LucioFex/gavia-hardware/docs/renders/conceptos_agua.jpg

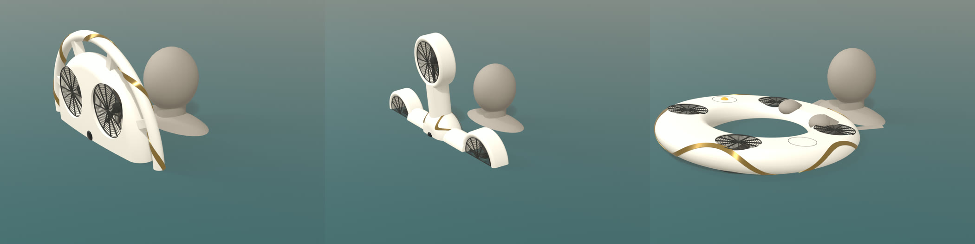
docs/renders/conceptos_agua.jpg
