LucioFex/gavia-hardware/docs/renders/gavia_aro_2_frente.jpg

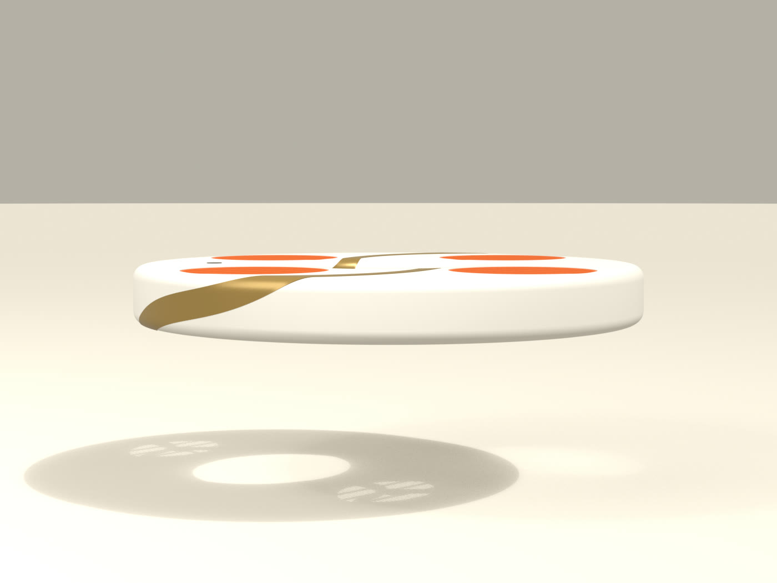
docs/renders/gavia_aro_2_frente.jpg
