LucioFex/gavia-hardware/docs/renders/gavia_aro_3_arriba.jpg

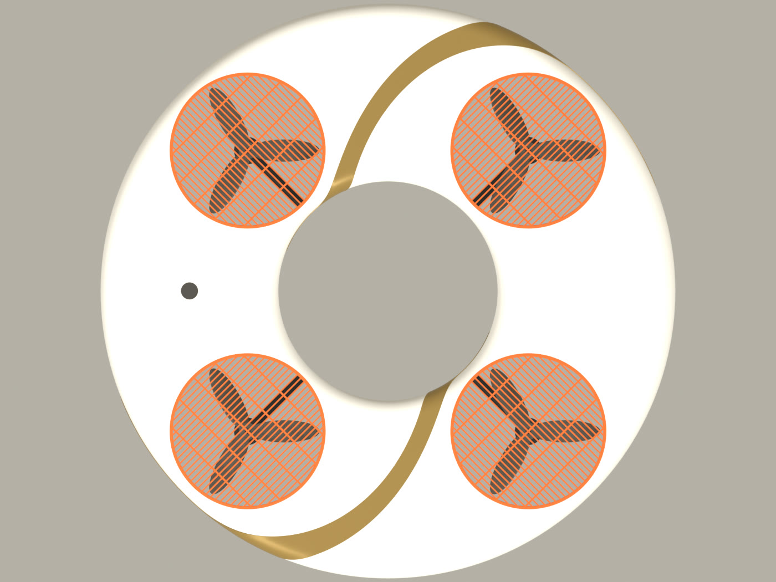
docs/renders/gavia_aro_3_arriba.jpg
