LucioFex/gavia-hardware/docs/renders/gavia_aro_4_detalle.jpg

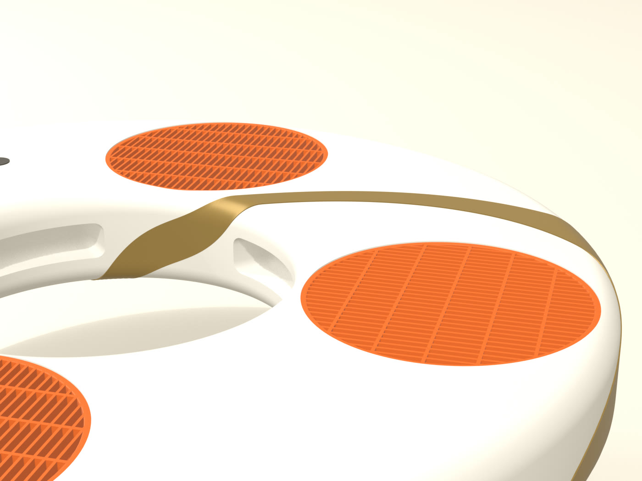
docs/renders/gavia_aro_4_detalle.jpg
