LucioFex/gavia-hardware/docs/renders/gavia_aro_5_agua.jpg

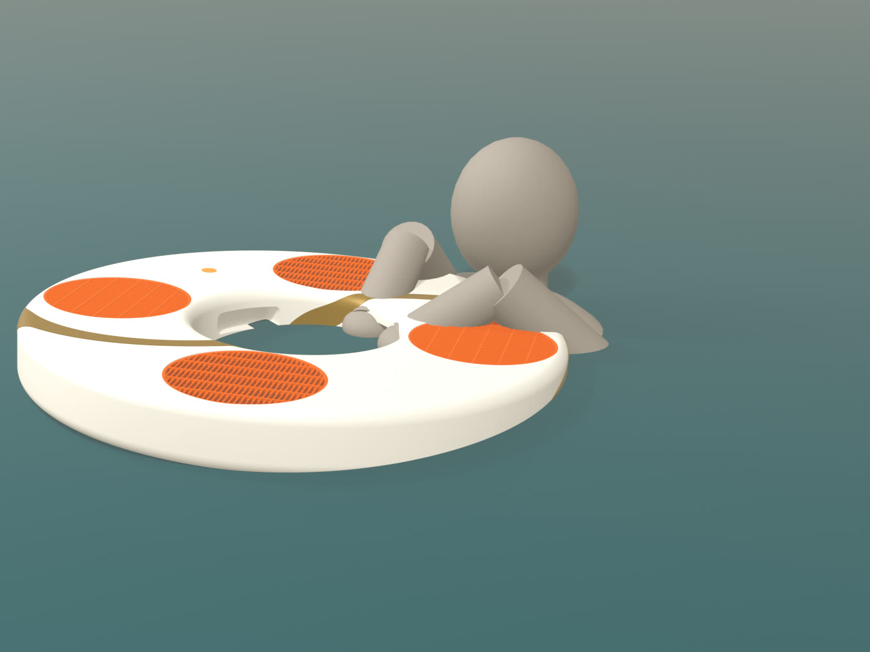
docs/renders/gavia_aro_5_agua.jpg
