LucioFex/gavia-hardware/docs/renders/gavia_aro_6_agua_guardavidas.jpg

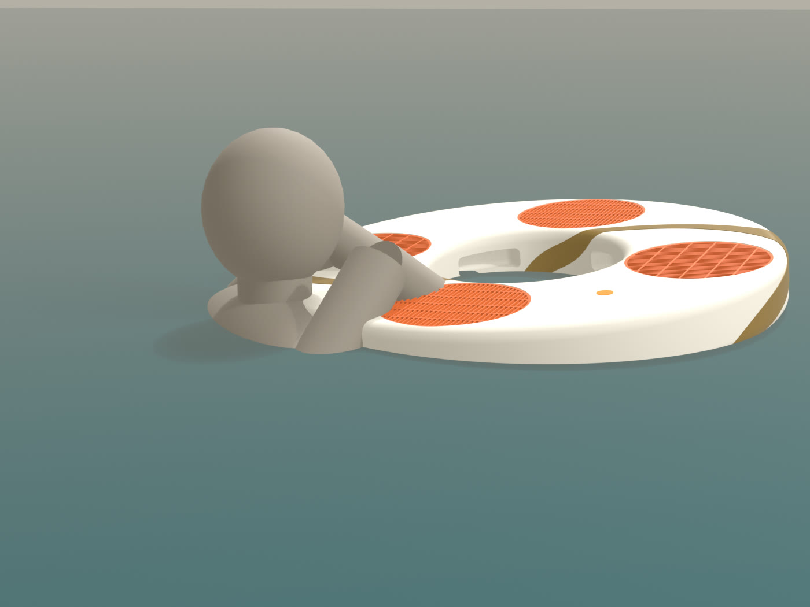
docs/renders/gavia_aro_6_agua_guardavidas.jpg
