LucioFex/gavia-hardware/docs/renders/gavia_aro_7_abajo.jpg

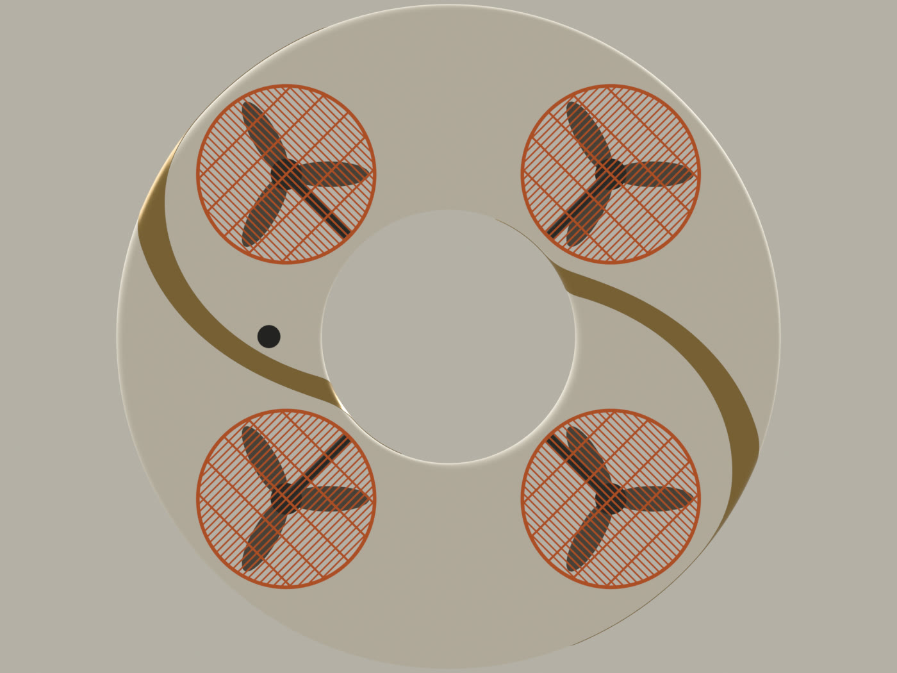
docs/renders/gavia_aro_7_abajo.jpg
