LucioFex/gavia-hardware/docs/renders/gavia_botonera_2_frente.jpg

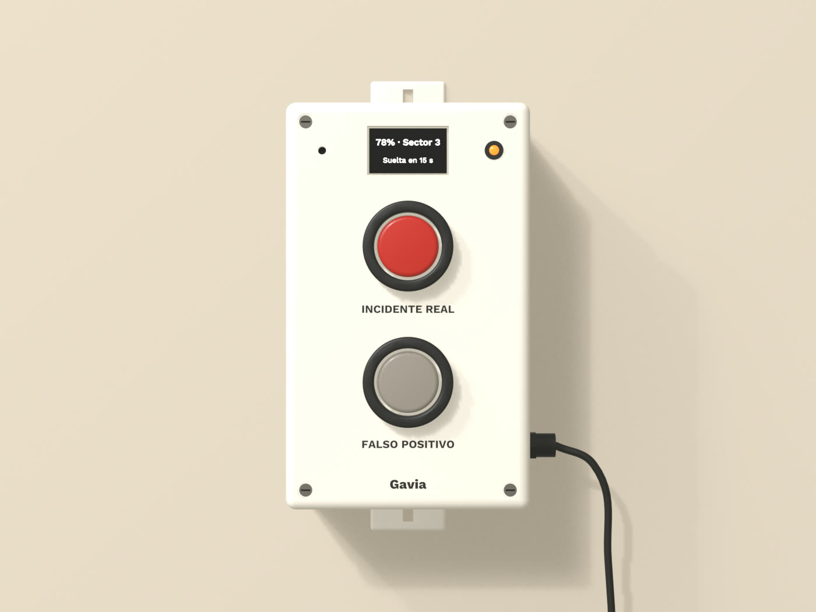
docs/renders/gavia_botonera_2_frente.jpg
