LucioFex/gavia-hardware/docs/renders/gavia_botonera_3_en_la_torre.jpg

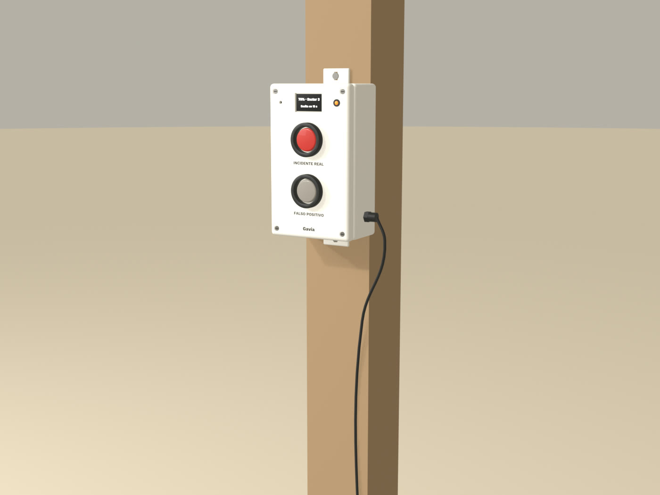
docs/renders/gavia_botonera_3_en_la_torre.jpg
