LucioFex/gavia-hardware/docs/roadmap/img/01-banco.jpg

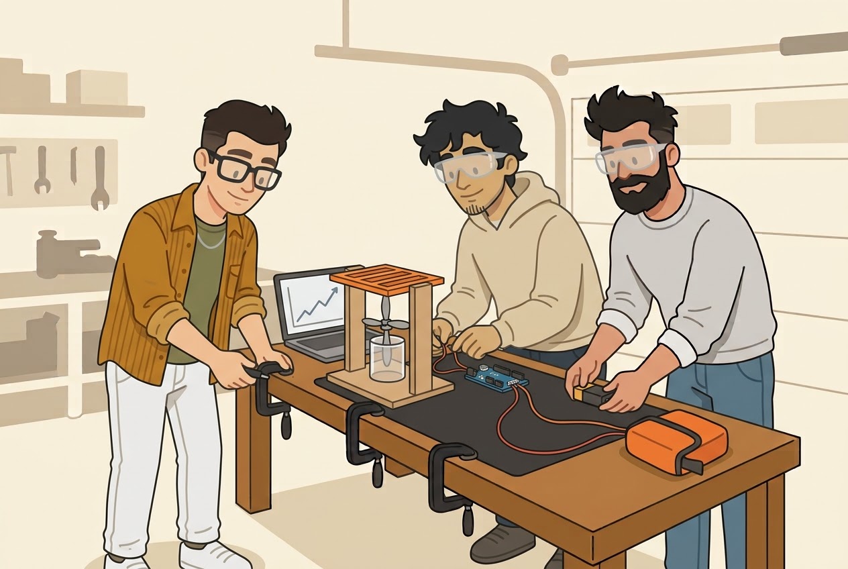
docs/roadmap/img/01-banco.jpg
