LucioFex/gavia-hardware/docs/roadmap/img/02-ducto.jpg

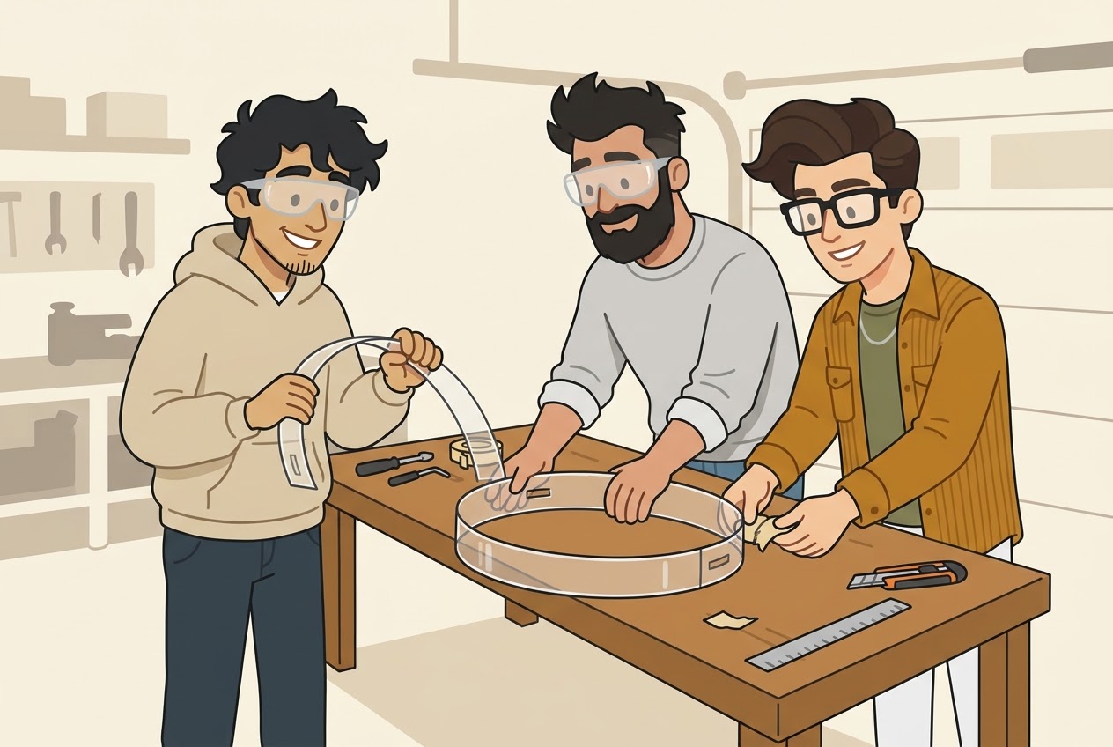
docs/roadmap/img/02-ducto.jpg
