LucioFex/gavia-hardware/docs/roadmap/img/03-soldar.jpg

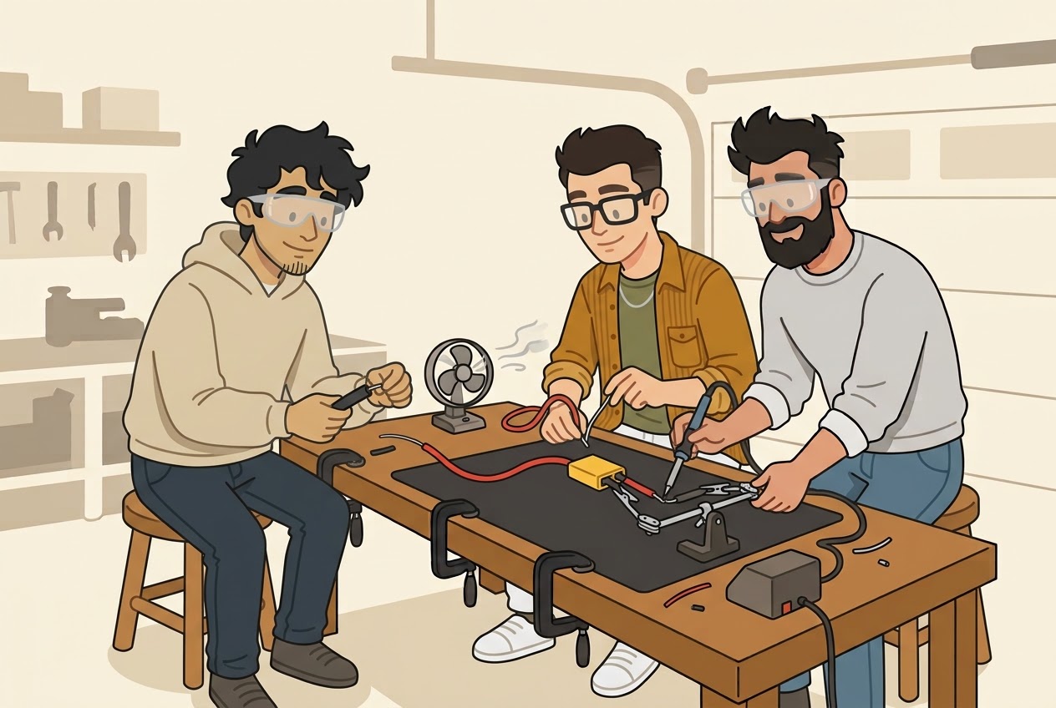
docs/roadmap/img/03-soldar.jpg
