LucioFex/gavia-hardware/docs/roadmap/img/06-taller.jpg

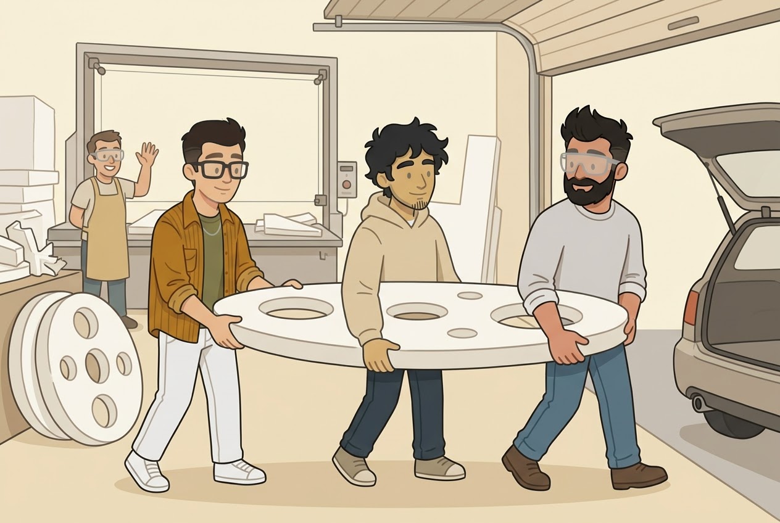
docs/roadmap/img/06-taller.jpg
