LucioFex/gavia-hardware/docs/roadmap/img/07-capas.jpg

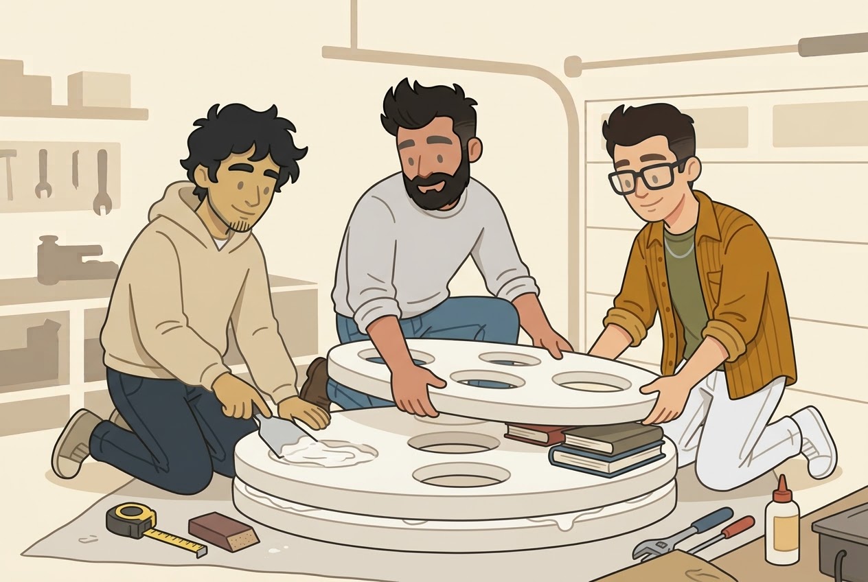
docs/roadmap/img/07-capas.jpg
