LucioFex/gavia-hardware/docs/roadmap/img/09-electronica.jpg

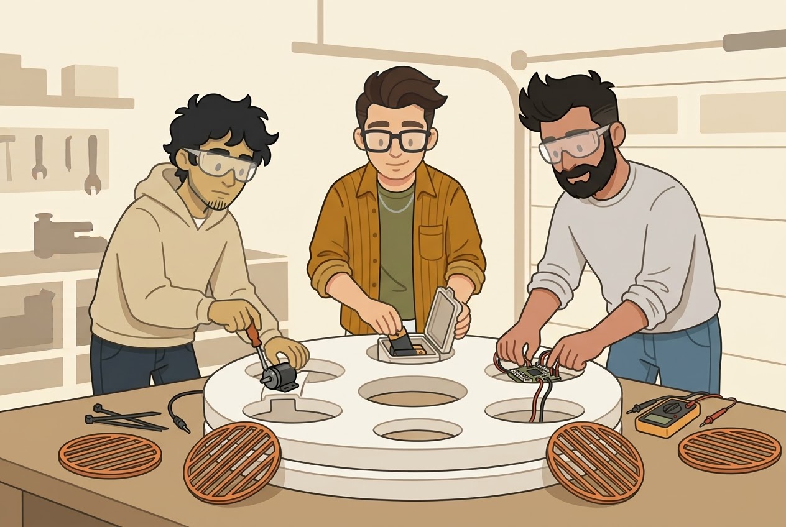
docs/roadmap/img/09-electronica.jpg
