LucioFex/gavia-hardware/docs/roadmap/img/10-vuelo-atado.jpg

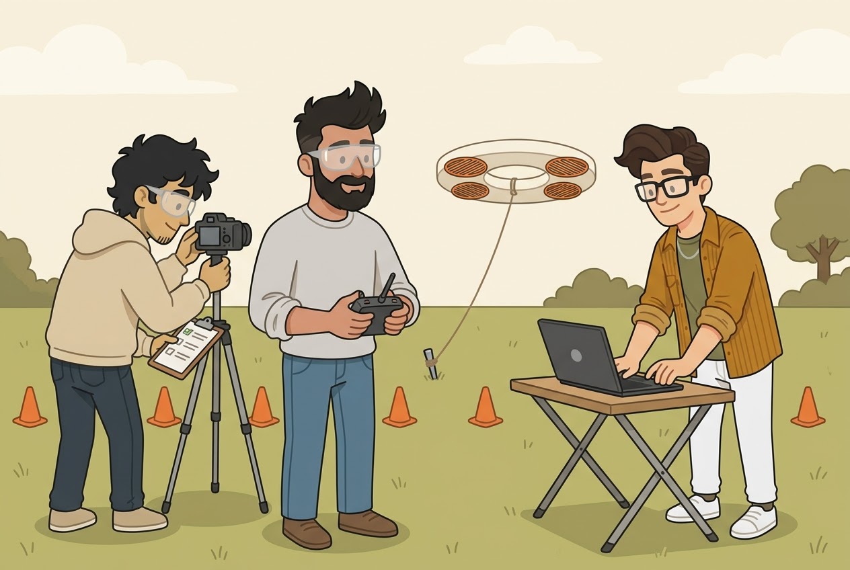
docs/roadmap/img/10-vuelo-atado.jpg
