LucioFex/gavia-hardware/docs/roadmap/img/11-playa.jpg

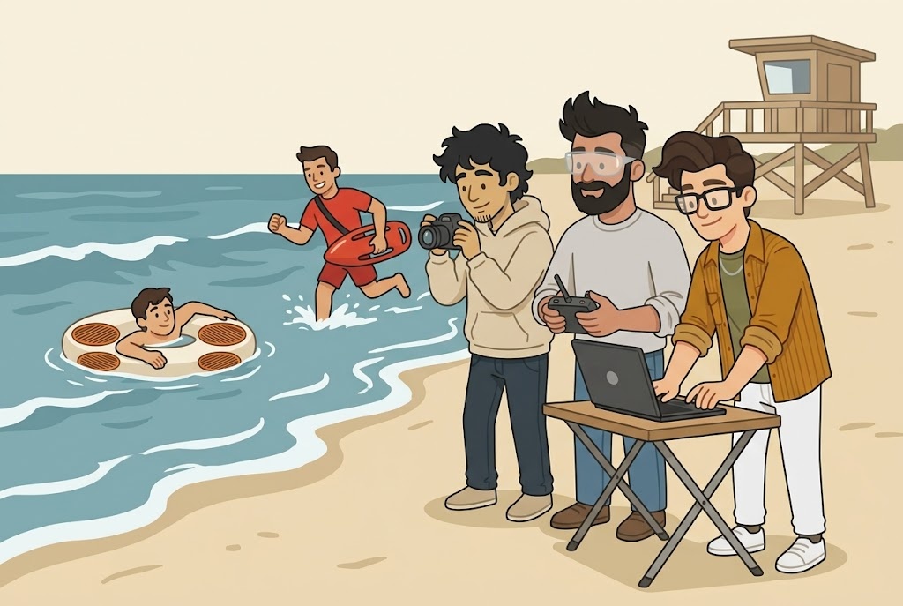
docs/roadmap/img/11-playa.jpg
