LucioFex/gavia-hardware/docs/materiales-y-conceptos/img/rejilla.png

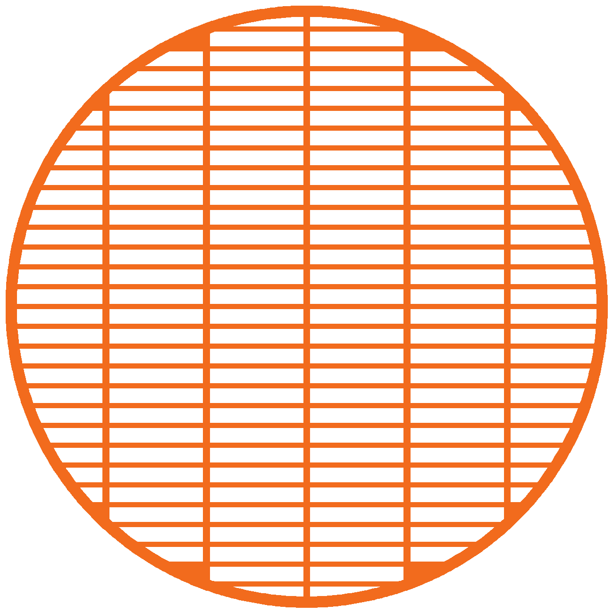
docs/materiales-y-conceptos/img/rejilla.png
