LucioFex/gavia-hardware/cad/banco/banco_mdf_1.dxf

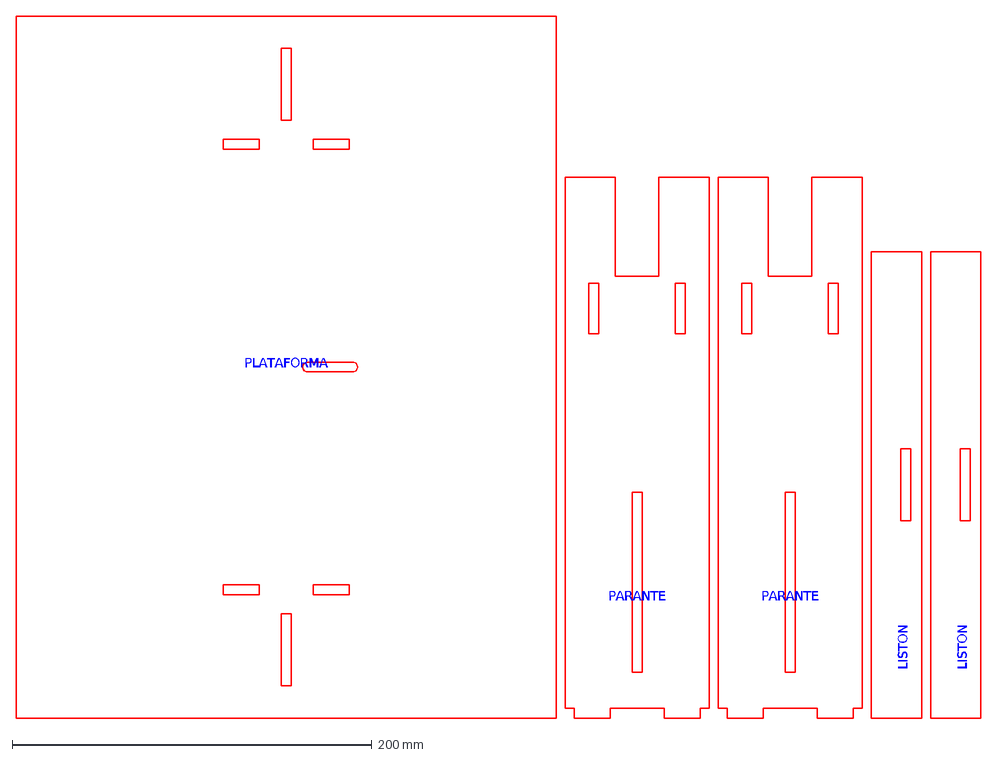
[picture p36: CAD file, 2026-10-30]
cad/banco/banco_mdf_1.dxf
PLATAFORMA
PARANTE
LISTON
