LucioFex/gavia-hardware/cad/cuerpo/capa_media.dxf

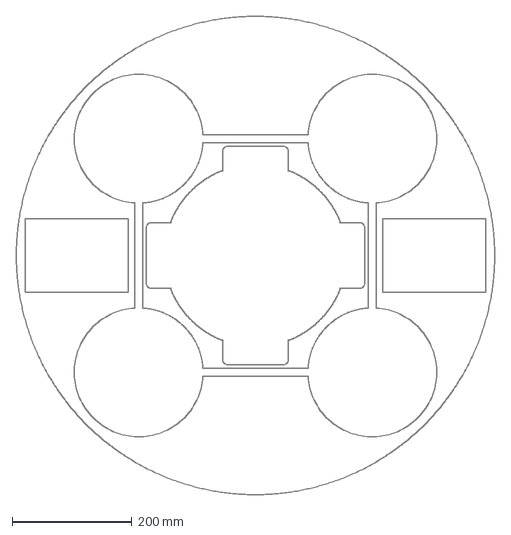
[picture p37: CAD file, 2026-10-30]
cad/cuerpo/capa_media.dxf
799.2 x 799.2 mm
