LucioFex/gavia-hardware/cad/banco/banco_mdf_2.dxf

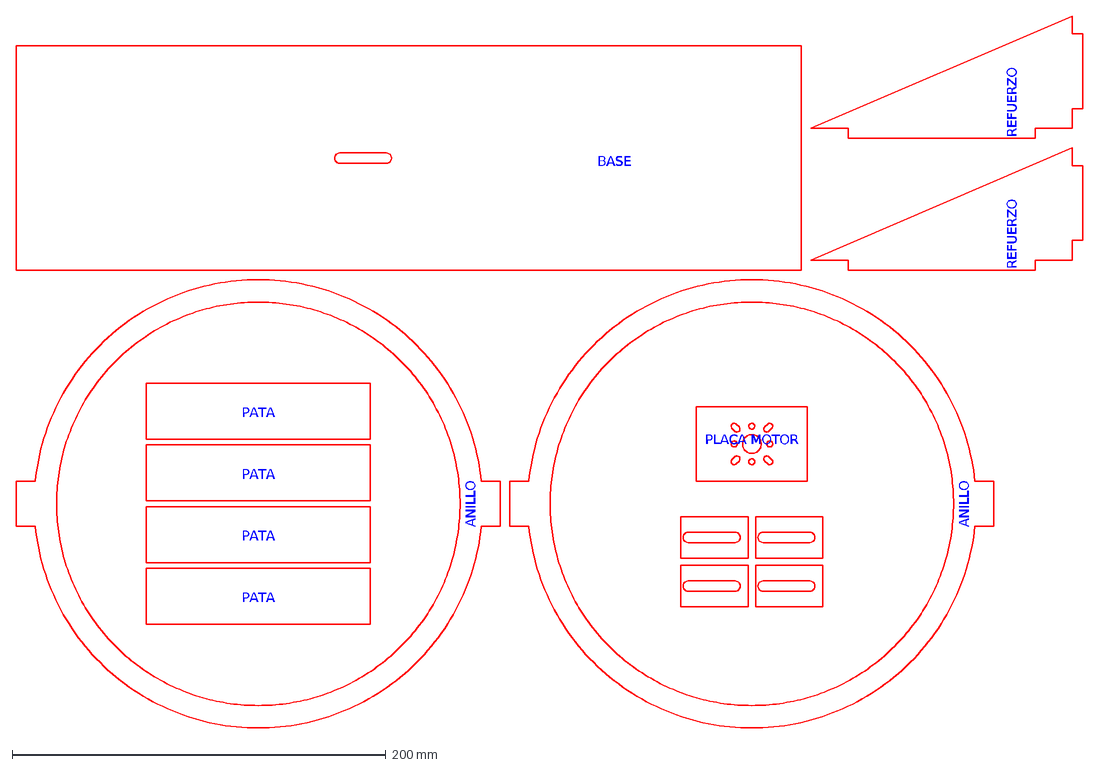
[picture p38: CAD file, 2026-10-30]
cad/banco/banco_mdf_2.dxf
ANILLO
PATA
PLACA MOTOR
BASE
REFUERZO
