LucioFex/gavia-hardware/cad/cuerpo/tapon_caja.dxf

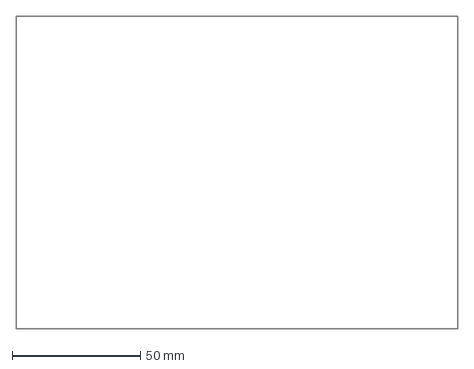
[picture p39: CAD file, 2026-10-30]
cad/cuerpo/tapon_caja.dxf
172.0 x 122.0 mm
