LucioFex/gavia-hardware/cad/banco/rejilla_banco.dxf

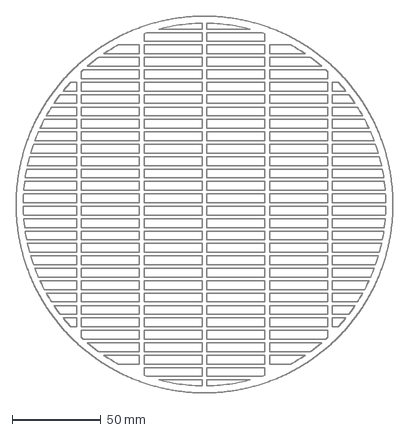
[picture p40: CAD file, 2026-10-30]
cad/banco/rejilla_banco.dxf
212.6 x 212.6 mm
