LucioFex/gavia-hardware/cad/cuerpo/capa_exterior.dxf

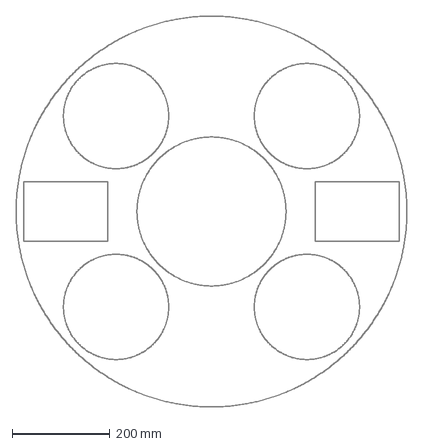
[picture p41: CAD file, 2026-10-30]
cad/cuerpo/capa_exterior.dxf
799.2 x 799.2 mm
