LucioFex/gavia-hardware/(list of files, cad)

Other CAD files:
cad/blender/gavia_aro_final.blend
cad/blender/gavia_aro_r1.blend
cad/blender/gavia_aro_r2.blend
cad/blender/gavia_botonera.blend
cad/blender/v1_disco.blend
cad/blender/v2_cruz.blend
cad/blender/v3_aro.blend
