LucioFex/gavia-hardware/(commit log)

2026-10-25 Estructura inicial del repo
    README con la idea del proyecto y la advertencia de prototipo
    experimental, licencia, NOTICE y estructura de carpetas.
2026-10-30 Dron flotador en Blender: tres conceptos, dos rondas y el aro final
    Scripts parametricos de Blender 5.2 con libreria comun (geometria, paleta,
    renders y ficha de fisica por voxeles), los conceptos disco, cruz y aro,
    dos rondas de refinamiento y la version final del aro de 800 mm con helices
    de 8 pulgadas. Renders finales en docs/renders y README actualizado.
    [gavia_aro_final.blend, gavia_aro_r1.blend, gavia_aro_r2.blend, v1_disco.blend, v2_cruz.blend, v3_aro.blend]
2026-10-30 Banco de empuje de un ducto: rejilla para corte láser y lista de materiales por fases
    rejilla_banco.py dibuja la rejilla en SVG y DXF con los parámetros de gavia_aro.py. La lista de materiales reemplaza la del dron de 5 pulgadas.
    [rejilla_banco.dxf]
2026-10-30 PDF de materiales y conceptos del prototipo
2026-10-30 Roadmap del prototipo por fases, banco en corte láser, cuerpo en capas de EPS y botonera en 3D
    PDF de roadmap con qué conseguir, qué mandar a cada taller y cómo armar cada fase. Kit del banco
    en MDF, capas del cuerpo para hilo caliente o CNC, modelo de la botonera con su lista de piezas,
    lista de materiales por fases nuevas y PDF de materiales y conceptos actualizado.
    [banco_mdf_1.dxf, banco_mdf_2.dxf, capa_exterior.dxf, capa_media.dxf, gavia_botonera.blend, tapon_caja.dxf]
2026-10-30 Roadmap: planes B si algo no está, celda de 10 kg cotizada y hélices juntas en la fase 1
2026-10-30 Prototipo con gastos ajustados, repuestos para lo que se rompe y todo cotizado
    - Roadmap: páginas nuevas "Gastar menos", "Si se rompe o se quema algo" y "Proveedores y
    servicios". Cargador importado, batería CNHL 6S 4000 con EC5, MicoAir743 con ESC sueltos,
    cuadrado de caño de aluminio, probador de LiPo y ESP32 de repuesto.
    - La radio pasa a la fase 1 para practicar en un simulador. Pasos gratis para no quemar nada.
    - Lista de materiales con lo que faltaba cotizar (botonera, piel, pilas, tornillos), talleres y
    referencias de precio. Total completo: unos USD 1.305 sin los servicios.
    - Materiales y conceptos: aluminio, EC5, probador de LiPo y ESC sueltos.
2026-10-31 Con el apoyo de diVenuo: el logo y la aclaración de que su marca no entra en la licencia
